DavidEwing/SNAP-Badge/docs/SNAPbadge_views-RevB_f1cd7e.pdf

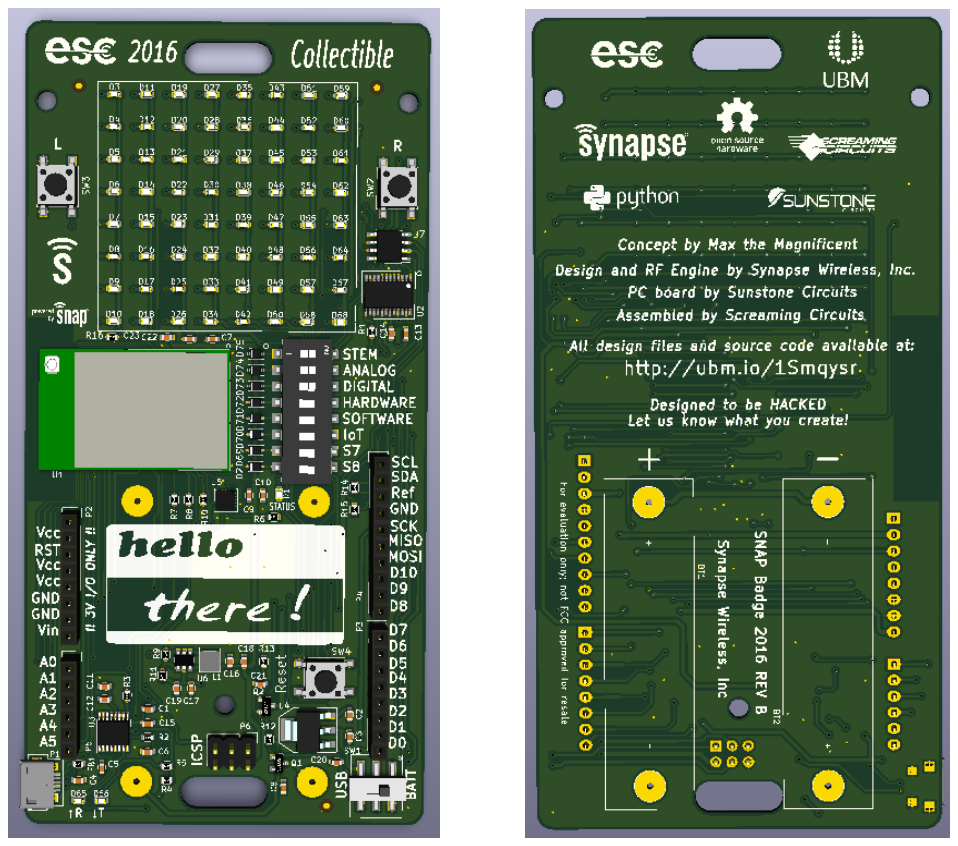
[picture p1: page 1]

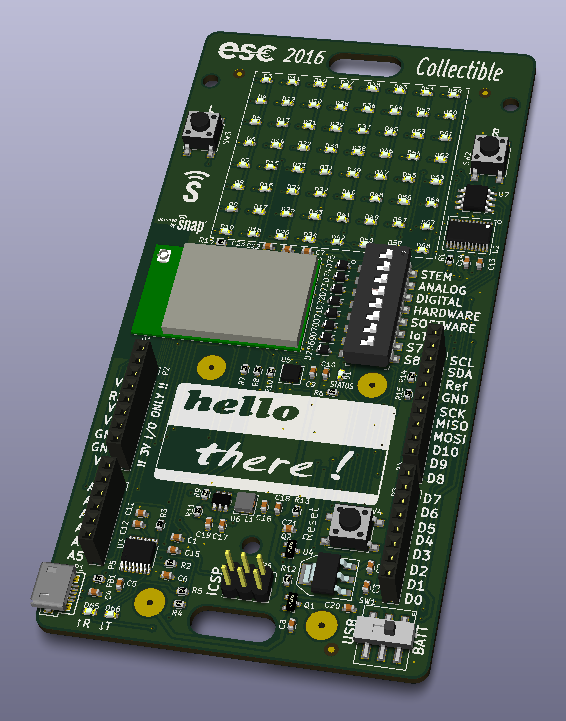
[picture p2: figure]
