DavidEwing/SNAP-Badge/docs/SNAPbadge_views-RevA_e351ad.pdf

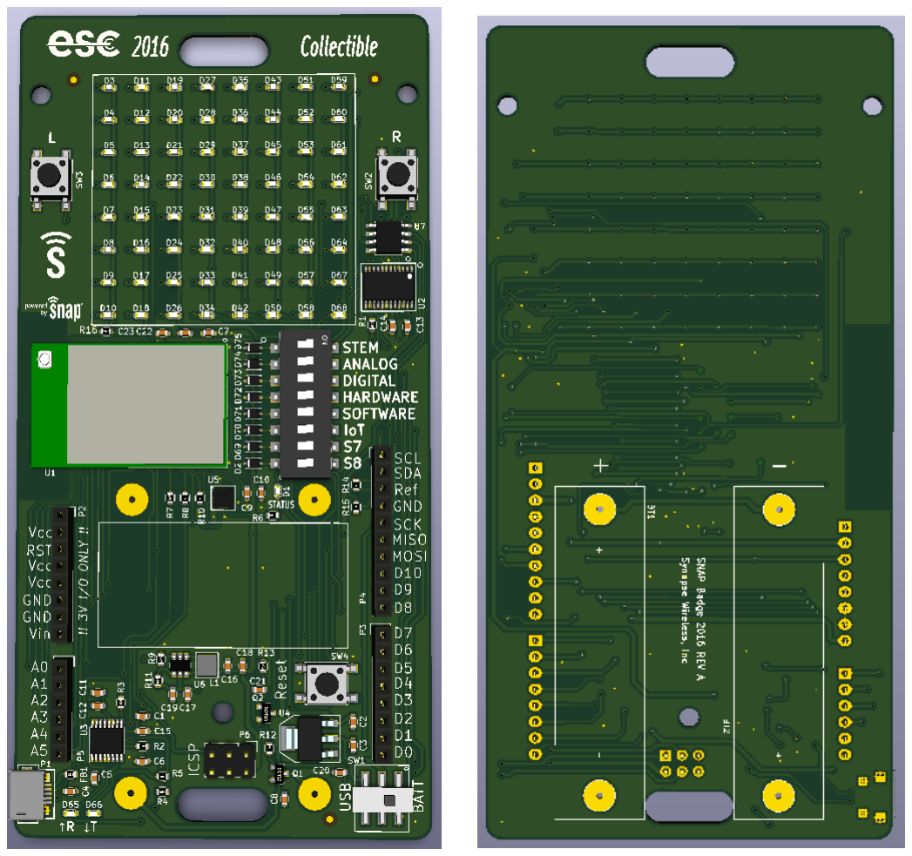
[picture p3: page 1]

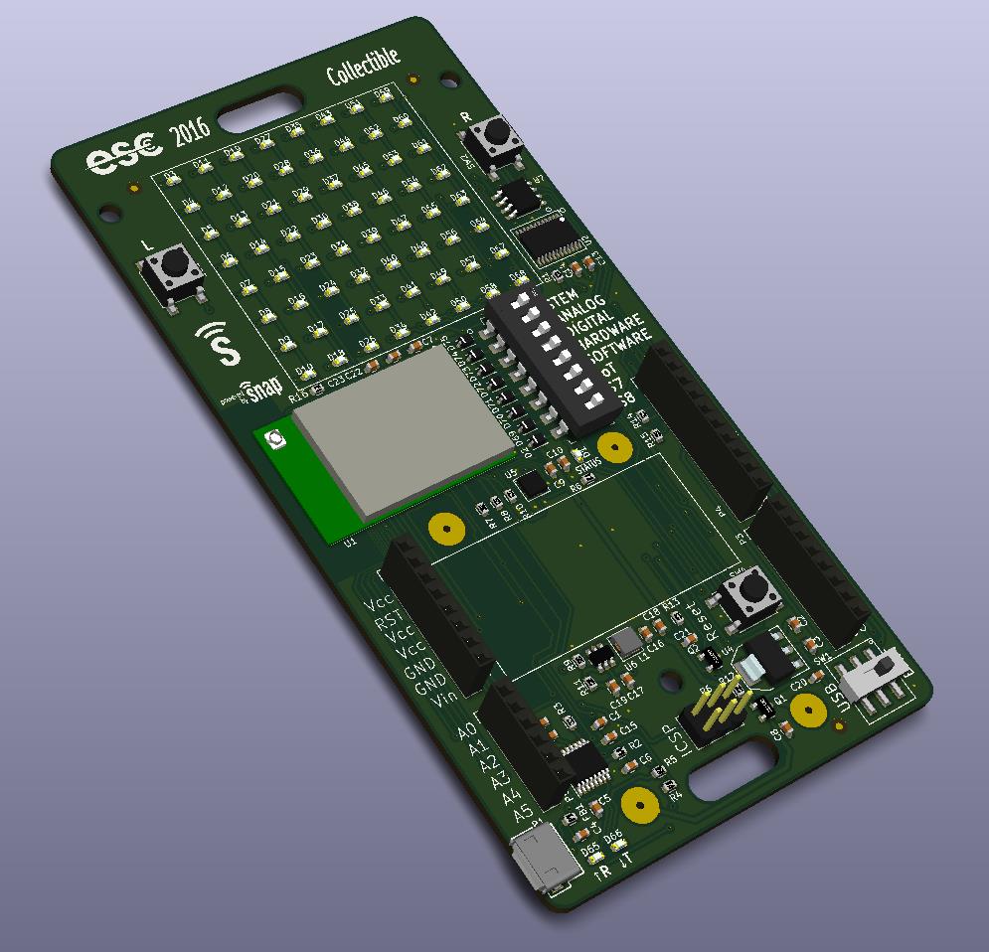
[picture p4: figure]
