DavidEwing/SNAP-Badge/docs/SNAPbadge_sch-RevB_f1cd7e.pdf

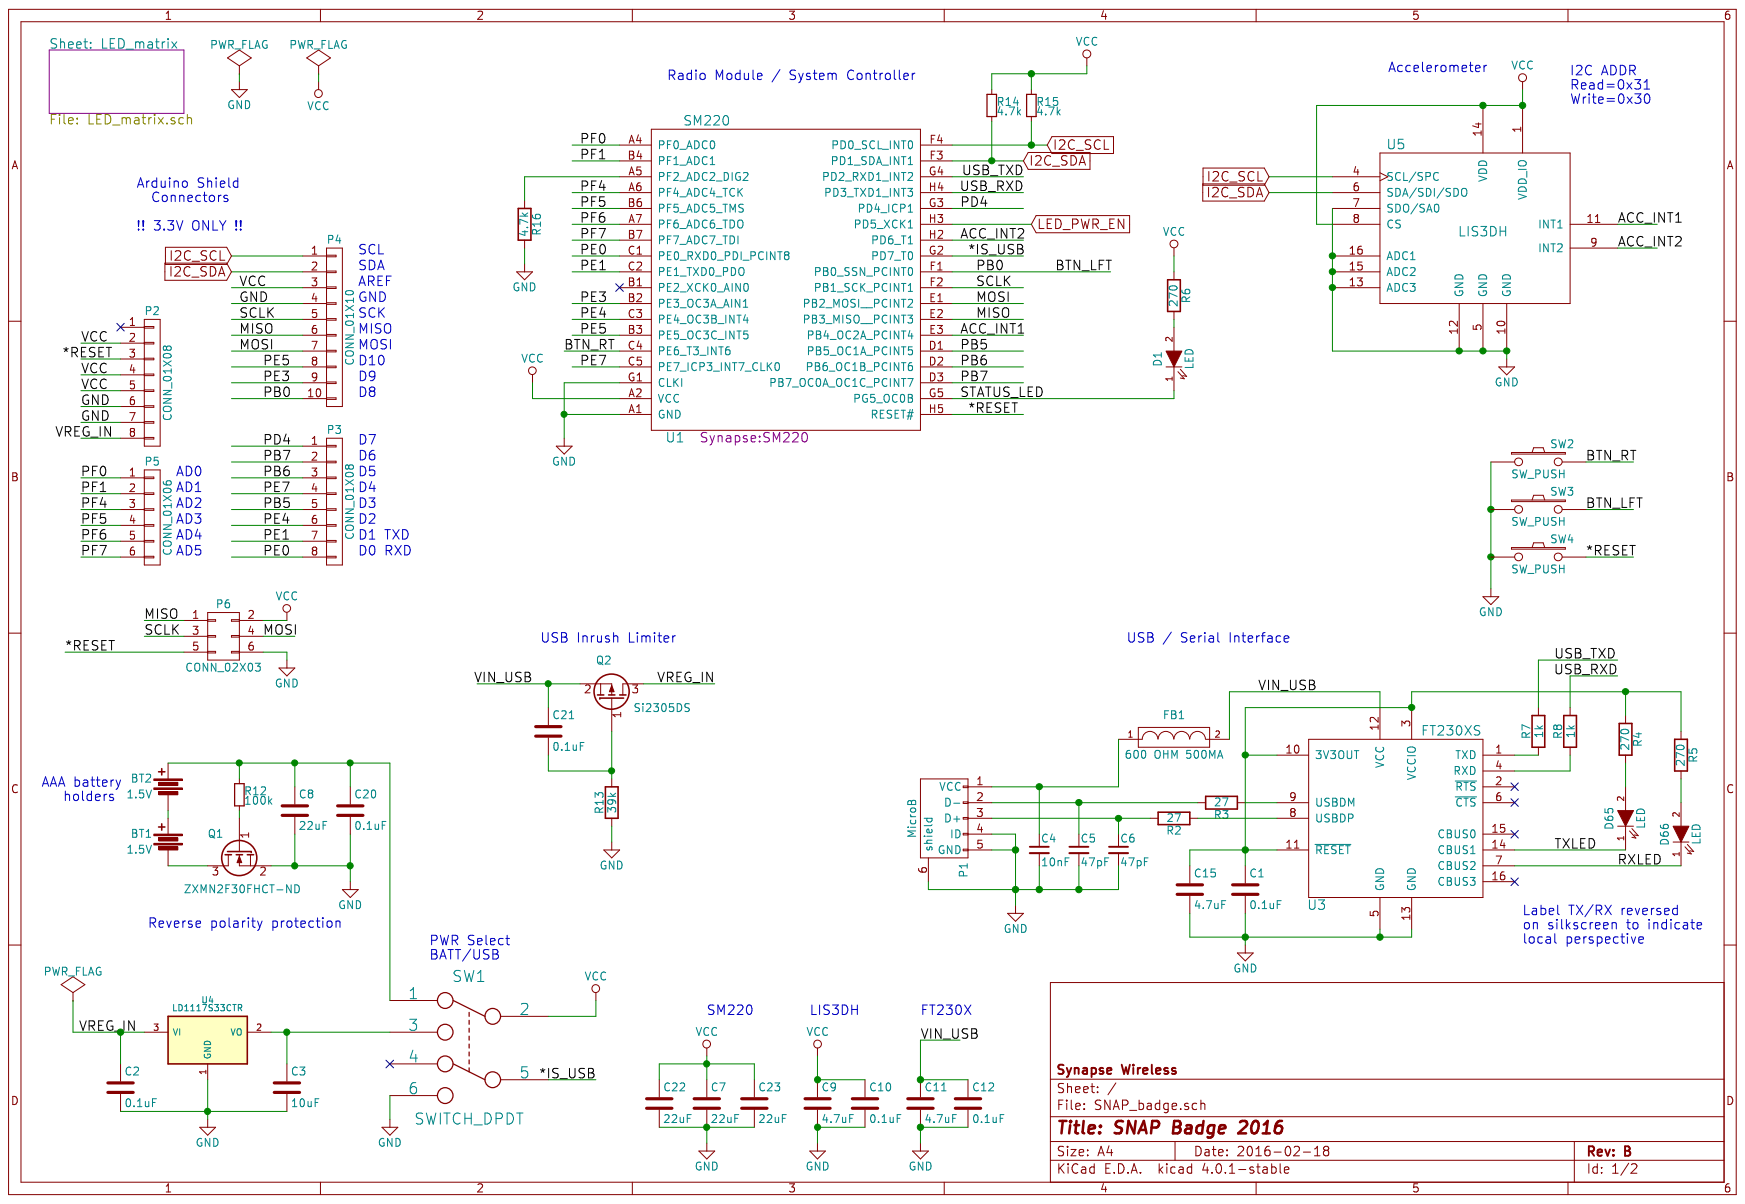
[picture p5: page 1]

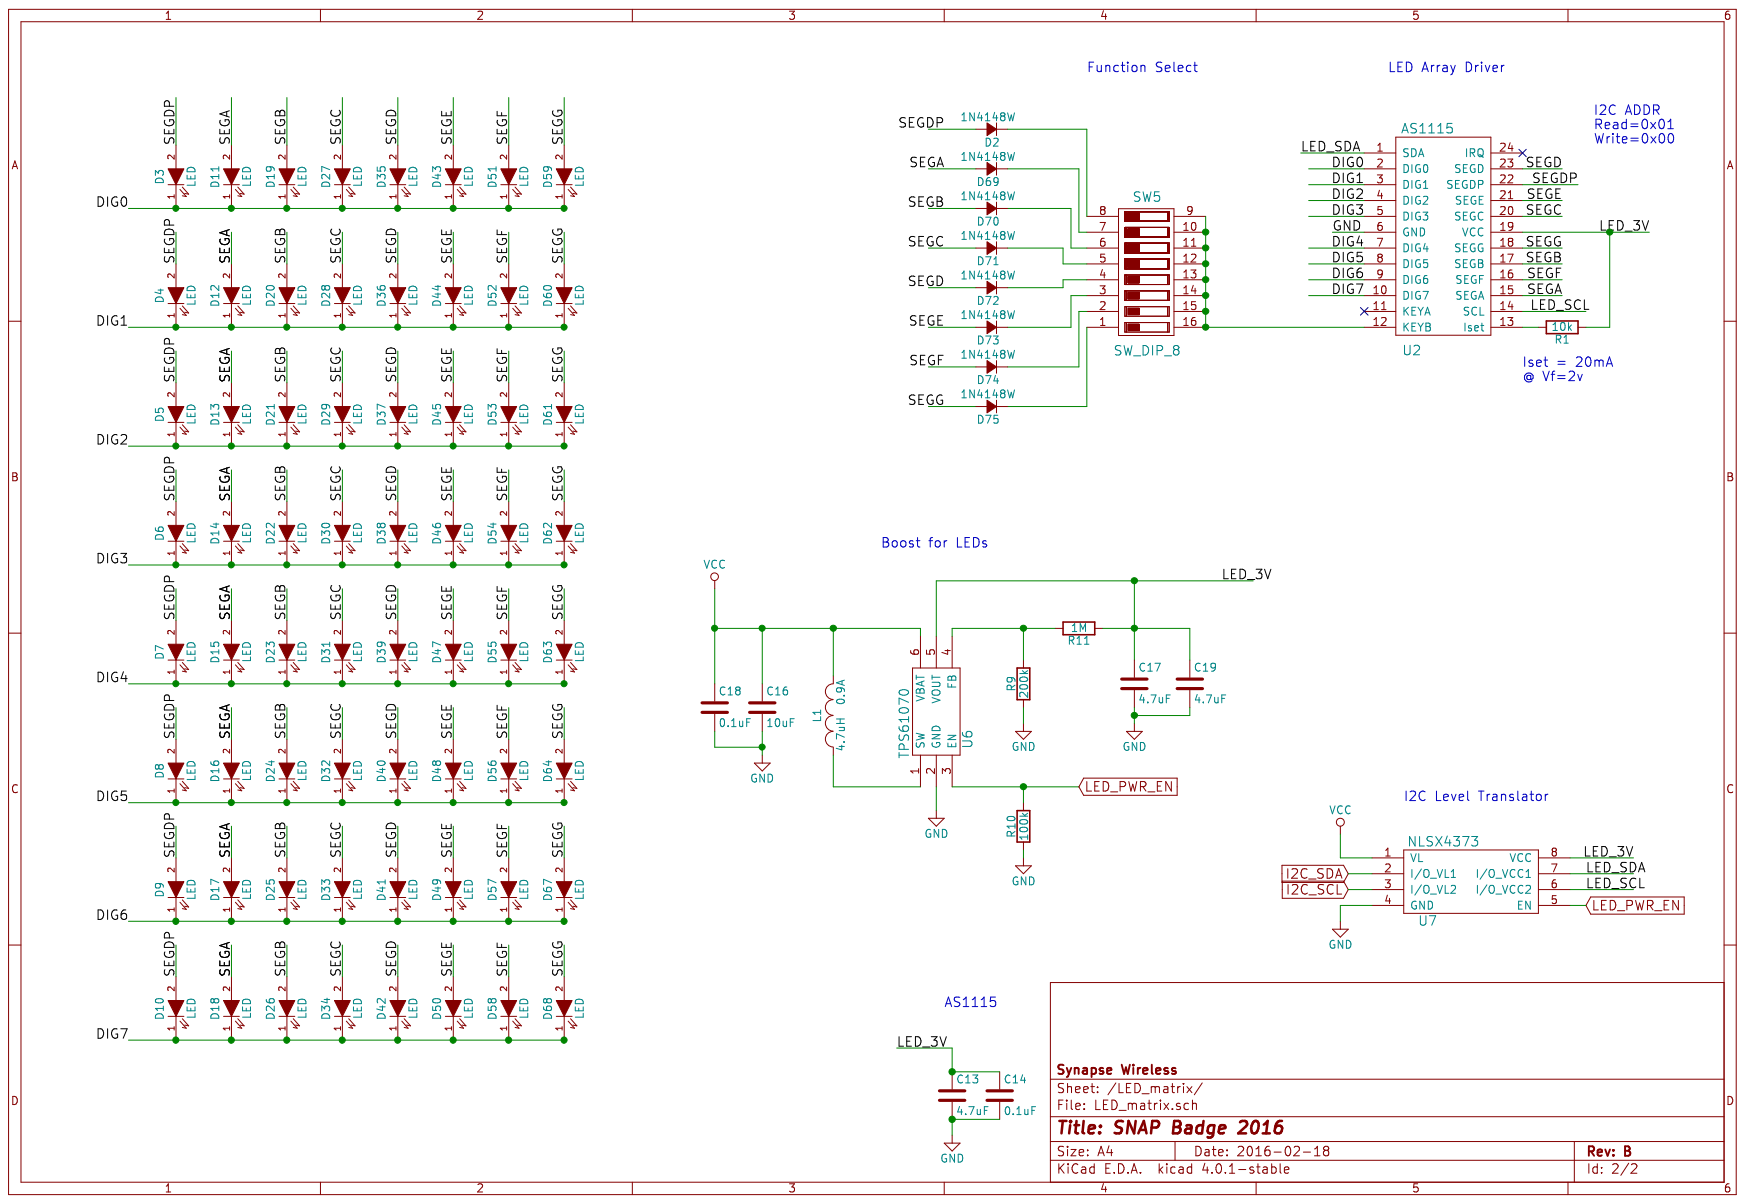
[picture p6: page 2]
