DavidEwing/SNAP-Badge/docs/SNAPbadge_sch-RevA_e351ad.pdf

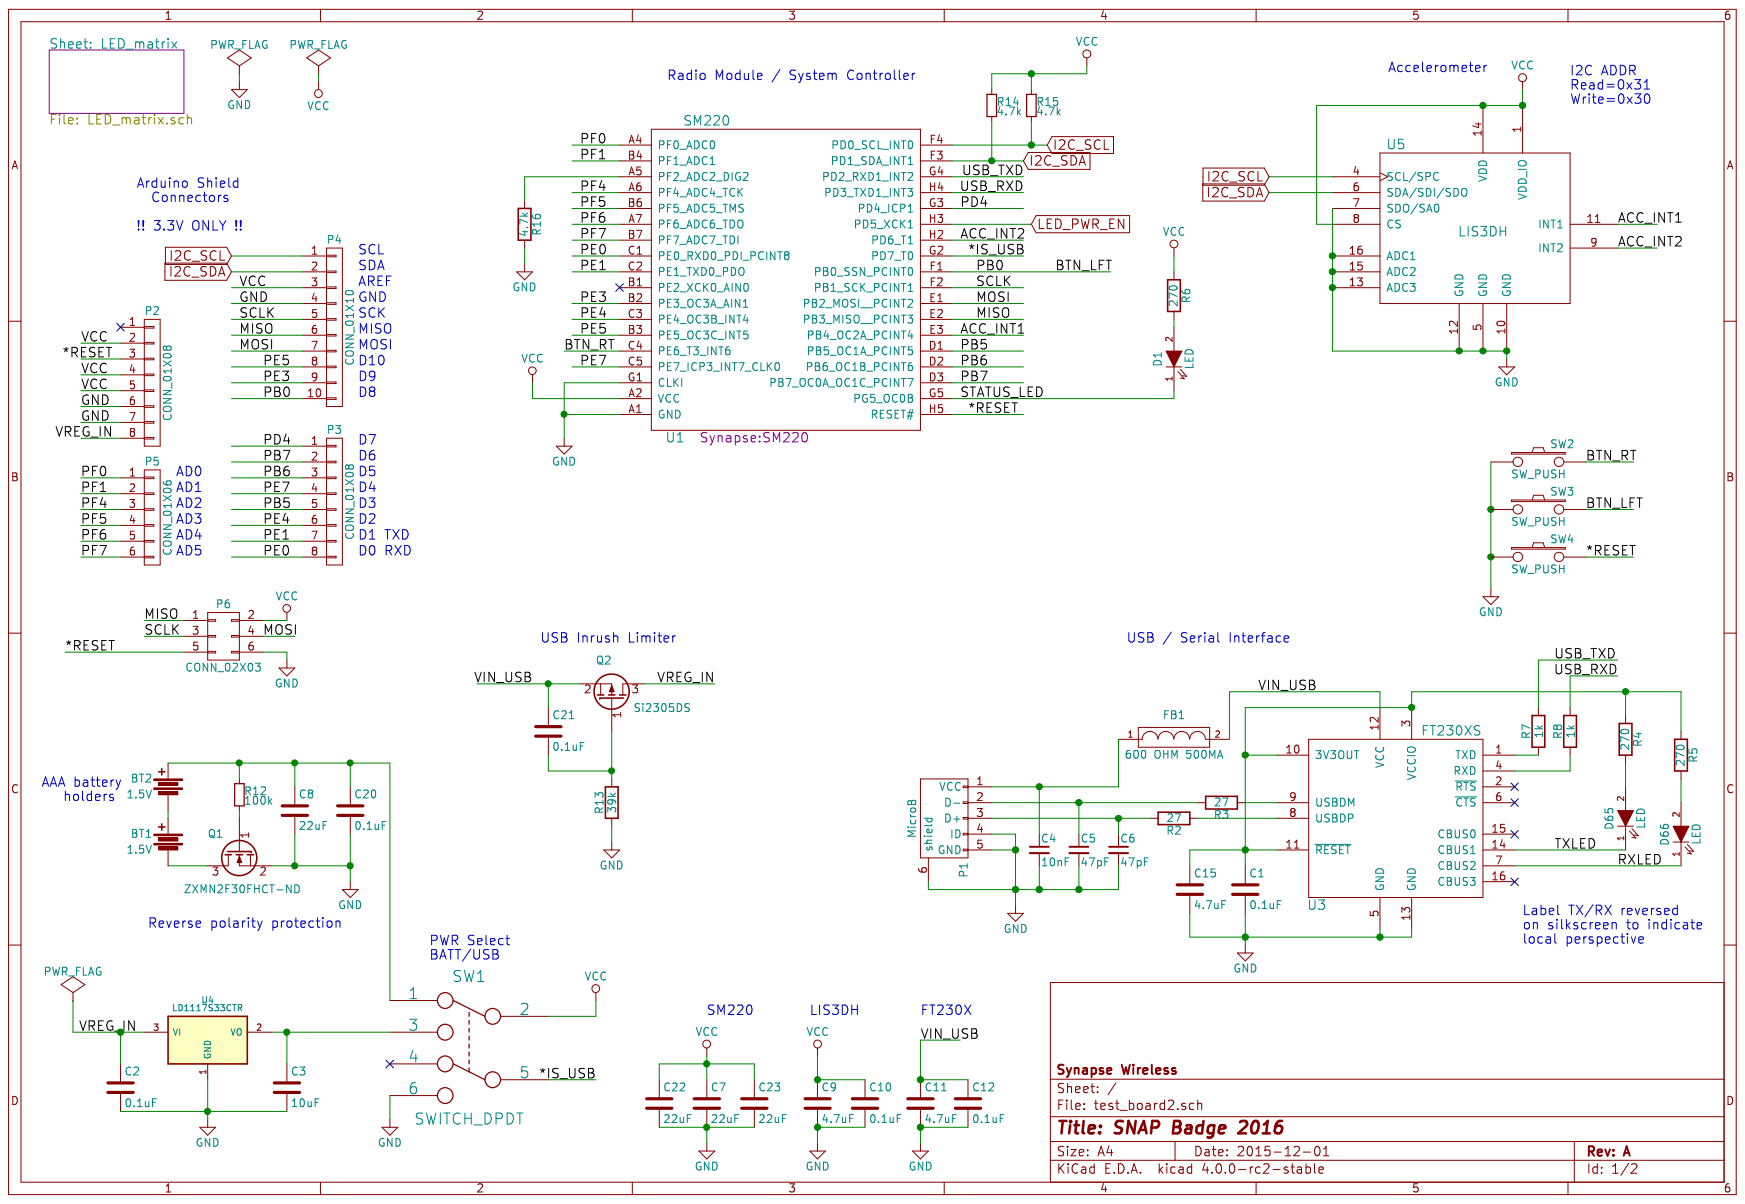
[picture p7: page 1]

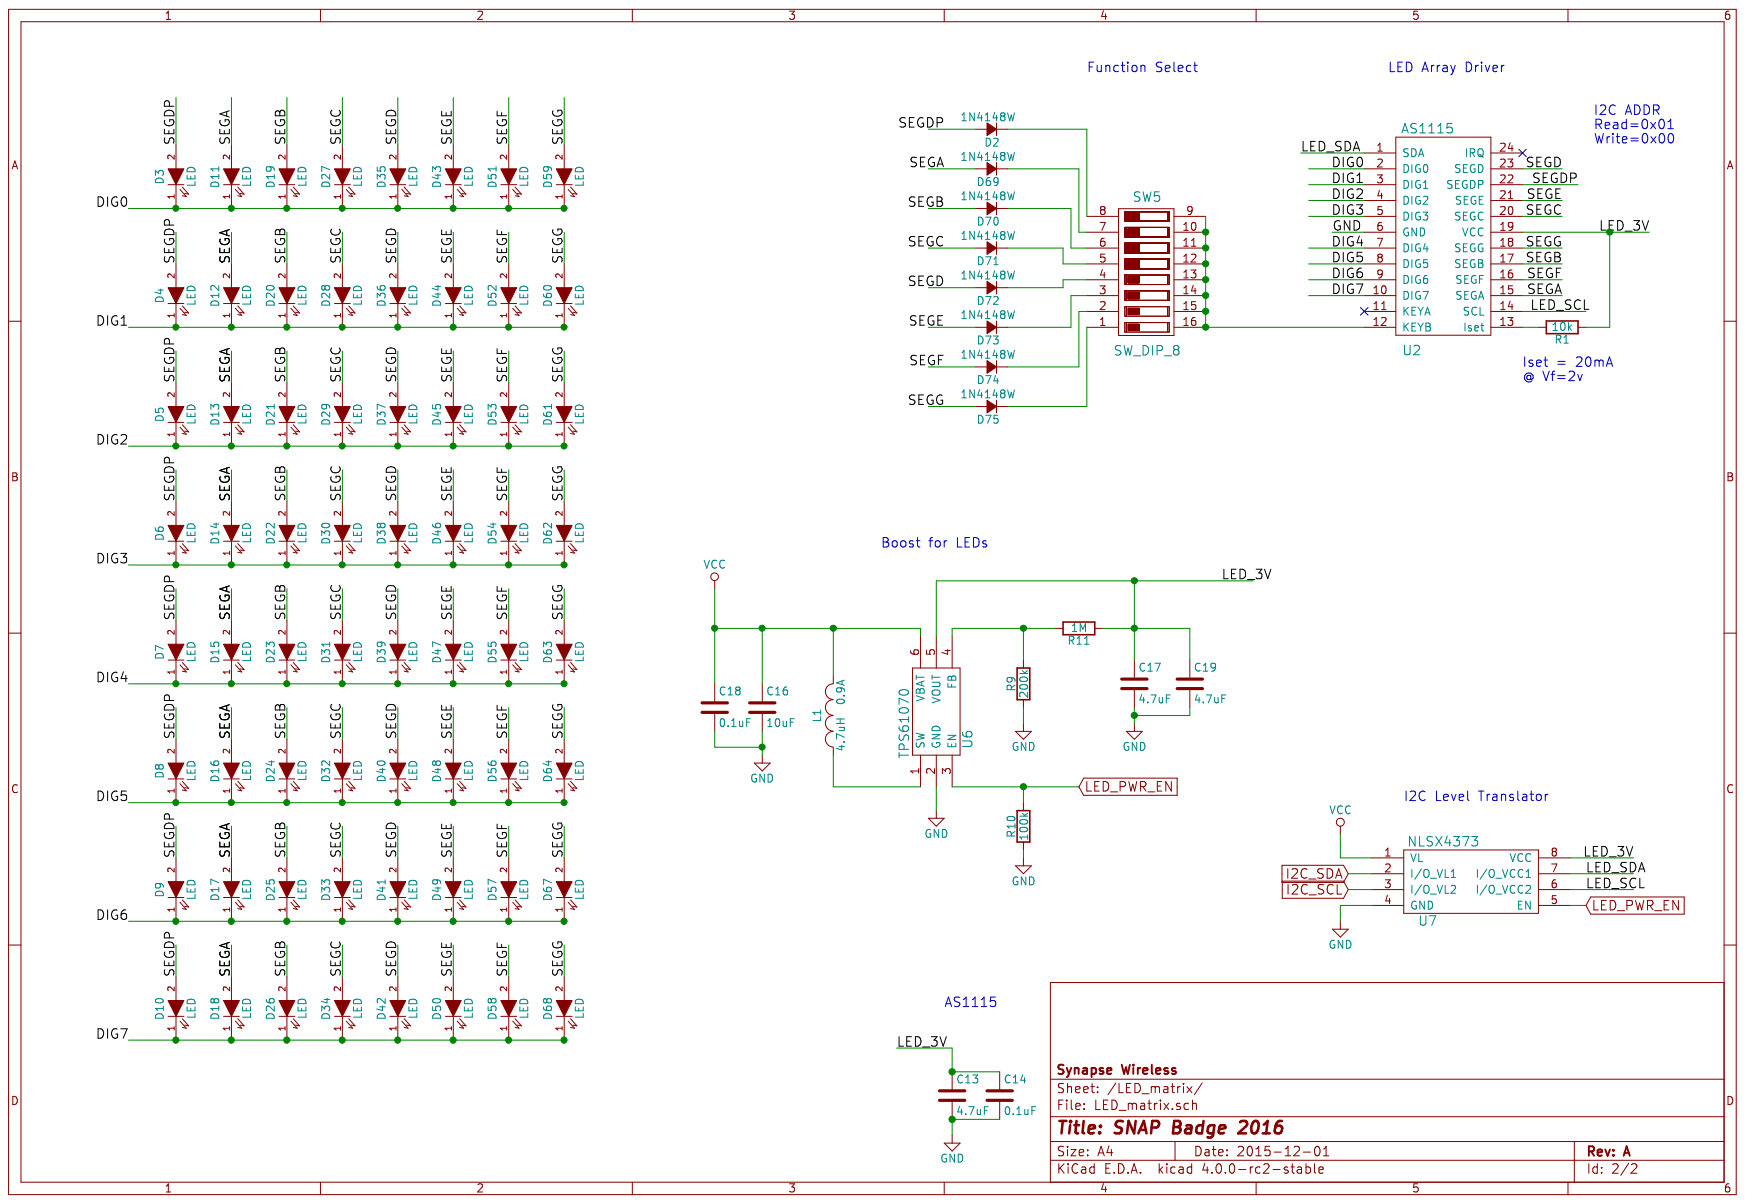
[picture p8: page 2]
