DavidEwing/SNAP-Badge/SNAP_badge.kicad_pcb

## KiCad design SNAP_badge.kicad_pcb (2016-02-18)

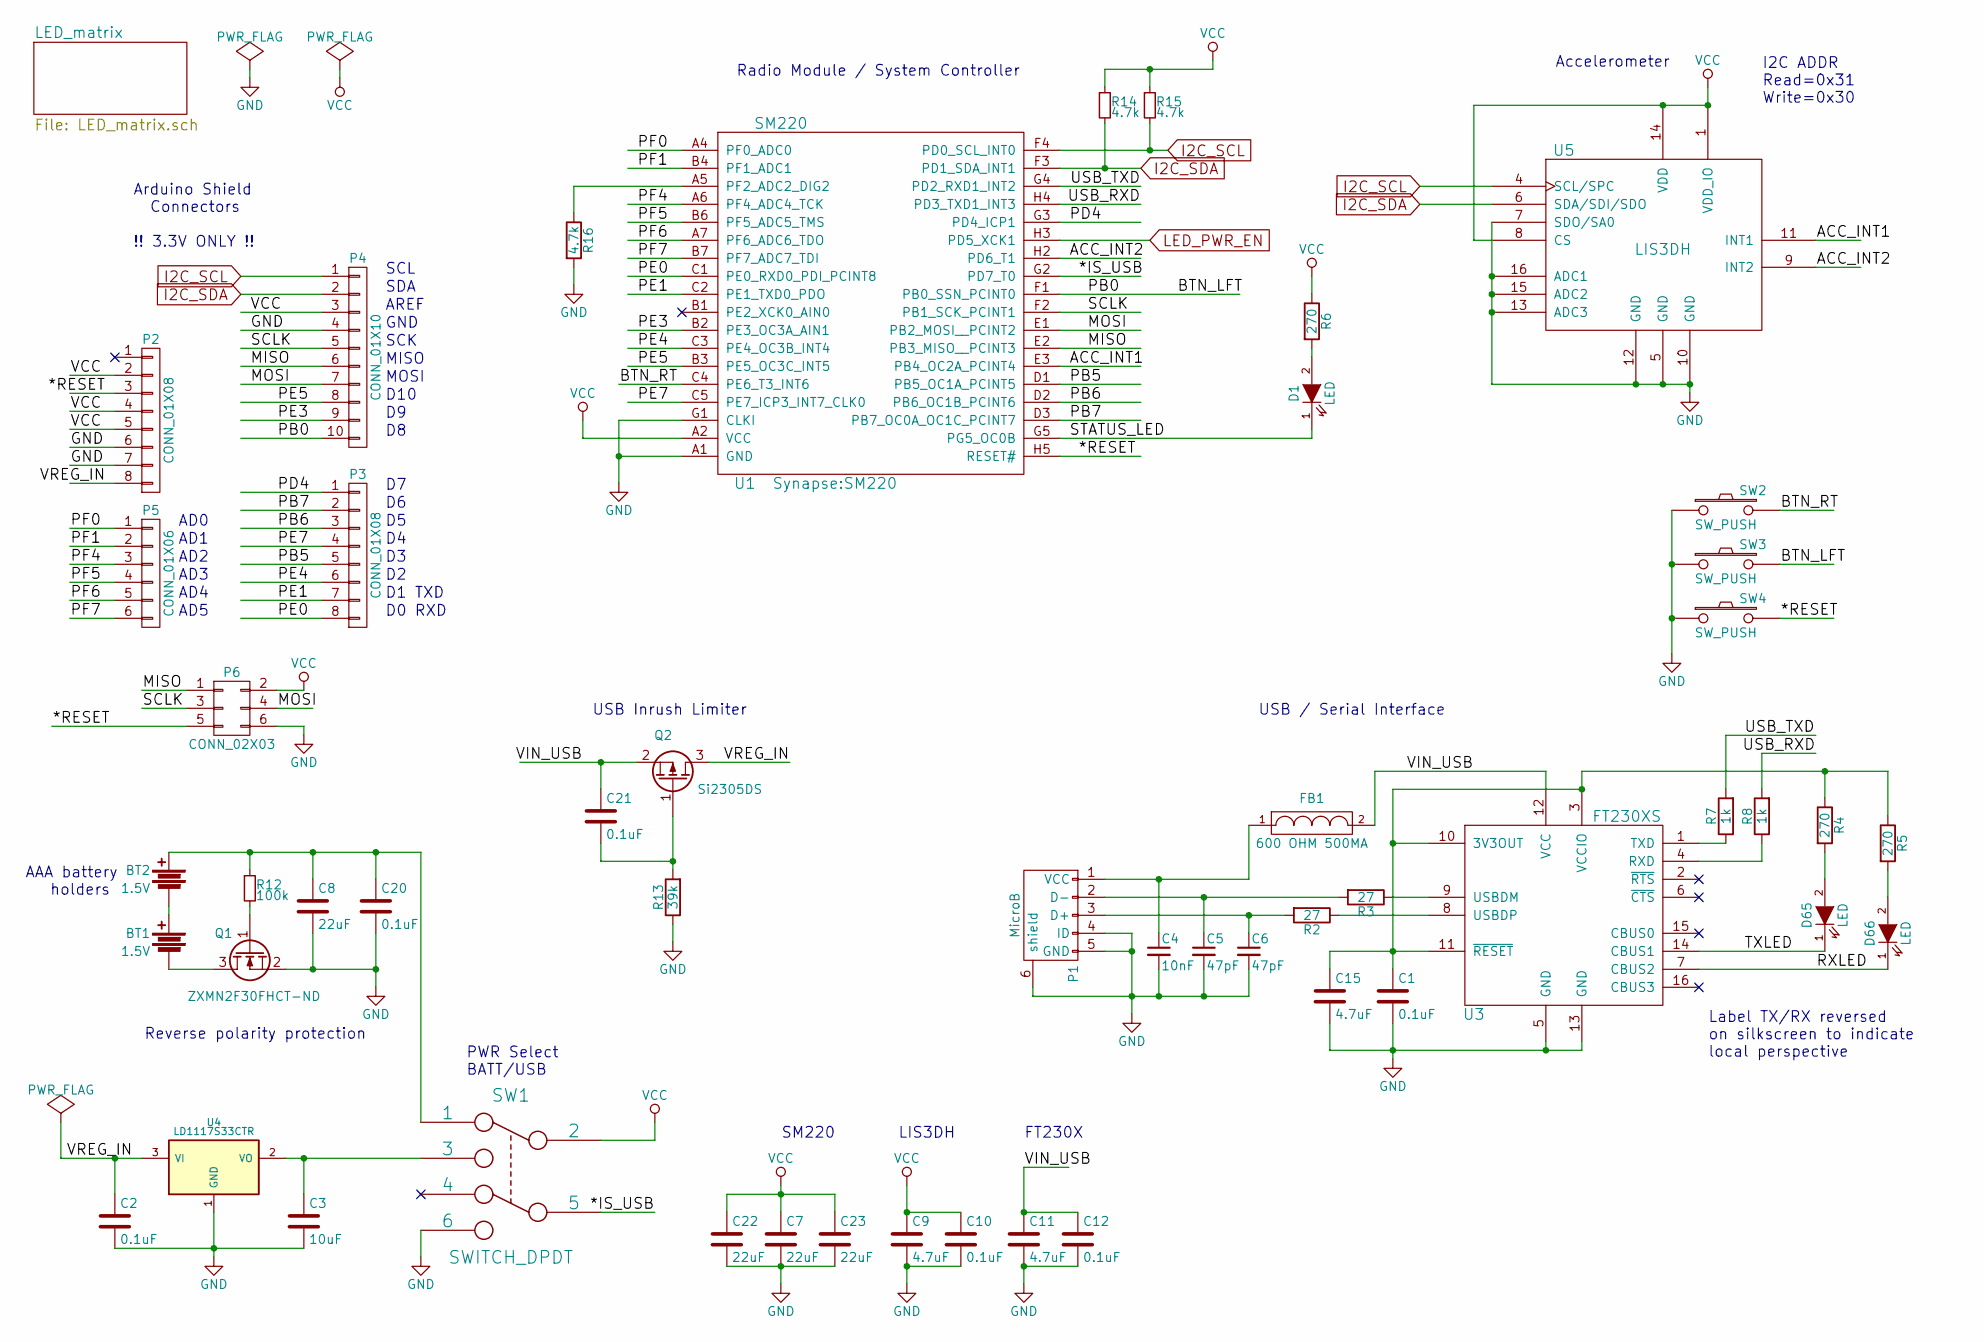
[picture p9: schematic SNAP_badge.sch, SNAP Badge 2016]

Parts:
BT1, BT2: 1.5V; BATT_2466
C1, C2, C10, C12, C20, C21: 0.1uF; C_0603
C3: 10uF; C_0603
C4: 10nF; C_0603
C5, C6: 47pF; C_0603
C7, C8, C22, C23: 22uF; C_0603
C9, C11, C15: 4.7uF; C_0603
D1, D65, D66: LED; Led_0603
FB1: 600 OHM 500MA; R_0603
P1: MicroB; USBmicroB
P2, P3: CONN_01X08; Socket_Strip_Straight_1x08
P4: CONN_01X10; Socket_Strip_Straight_1x10
P5: CONN_01X06; Socket_Strip_Straight_1x06
P6: CONN_02X03; Pin_Header_Straight_2x03
Q1: ZXMN2F30FHCT-ND; SOT-23
Q2: Si2305DS; SOT-23
R2, R3: 27; R_0603
R4, R5, R6: 270; R_0603
R7, R8: 1k; R_0603
R12: 100k; R_0603
R13: 39k; R_0603
R14, R15, R16: 4.7k; R_0603
SW1: SWITCH_DPDT; SO-DPDT-6
SW2, SW3, SW4: SW_PUSH; SW_SPST_PTS645
U1: SM220
U3: FT230XS; SSOP-16_3.9x4.9mm_Pitch0.635mm
U4: LD1117S33CTR; SOT-223
U5: LIS3DH; LGA16_3x3

Connections:
/*IS_USB: SW1.5, U1.G2 (PD7_T0)
/*RESET: P2.3, P6.5, SW4.2, U1.H5 (RESET#)
/ACC_INT1: U1.E3 (PB4_OC2A_PCINT4), U5.11 (INT1)
/ACC_INT2: U1.H2 (PD6_T1), U5.9 (INT2)
/BTN_LFT: P4.10, SW3.2, U1.F1 (PB0_SSN_PCINT0)
/BTN_RT: SW2.2, U1.C4 (PE6_T3_INT6)
/MISO: P4.6, P6.1, U1.E2 (PB3_MISO__PCINT3)
/MOSI: P4.7, P6.4, U1.E1 (PB2_MOSI__PCINT2)
/PB5: P3.5, U1.D1 (PB5_OC1A_PCINT5)
/PB6: P3.3, U1.D2 (PB6_OC1B_PCINT6)
/PB7: P3.2, U1.D3 (PB7_OC0A_OC1C_PCINT7)
/PD4: P3.1, U1.G3 (PD4_ICP1)
/PE0: P3.8, U1.C1 (PE0_RXD0_PDI_PCINT8)
/PE1: P3.7, U1.C2 (PE1_TXD0_PDO)
/PE3: P4.9, U1.B2 (PE3_OC3A_AIN1)
/PE4: P3.6, U1.C3 (PE4_OC3B_INT4)
/PE5: P4.8, U1.B3 (PE5_OC3C_INT5)
/PE7: P3.4, U1.C5 (PE7_ICP3_INT7_CLK0)
/PF0: P5.1, U1.A4 (PF0_ADC0)
/PF1: P5.2, U1.B4 (PF1_ADC1)
/PF4: P5.3, U1.A6 (PF4_ADC4_TCK)
/PF5: P5.4, U1.B6 (PF5_ADC5_TMS)
/PF6: P5.5, U1.A7 (PF6_ADC6_TDO)
/PF7: P5.6, U1.B7 (PF7_ADC7_TDI)
/RXLED: D66.1 (K), U3.7 (CBUS2)
/SCLK: P4.5, P6.3, U1.F2 (PB1_SCK_PCINT1)
/STATUS_LED: D1.1 (K), U1.G5 (PG5_OC0B)
/TXLED: D65.1 (K), U3.14 (CBUS1)
/USB_RXD: R8.2, U1.H4 (PD3_TXD1_INT3)
/USB_TXD: R7.2, U1.G4 (PD2_RXD1_INT2)
/VIN_USB: C11.1, C12.1, C21.1, FB1.2, Q2.2 (S), U3.12 (VCC)
/VREG_IN: C2.1, P2.8, Q2.3 (D), U4.3 (VI)
GND: C1.2, C2.2, C3.2, C4.2, C5.2, C6.2, C7.2, C8.2, C9.2, C10.2, C11.2, C12.2, C15.2, C20.2, C22.2, C23.2, P1.4 (ID), P1.5 (GND), P1.6 (shield), P2.6, P2.7, P4.4, P6.6, Q1.2 (S), R13.1, R16.2, SW1.6, SW2.1, SW3.1, SW4.1, U1.A1 (GND), U1.A8 (GND), U1.B8 (GND), U1.D8 (GND), U1.F8 (GND), U1.G1 (CLKI), U1.G8 (GND), U1.H1 (GND), U1.H8 (GND), U3.5 (GND), U3.13 (GND), U4.1 (GND), U5.5 (GND), U5.7 (SDO/SA0), U5.10 (GND), U5.12 (GND), U5.13 (ADC3), U5.15 (ADC2), U5.16 (ADC1); also elsewhere on the board
I2C_SCL: P4.1, R15.2, U1.F4 (PD0_SCL_INT0), U5.4 (SCL/SPC); also elsewhere on the board
I2C_SDA: P4.2, R14.2, U1.F3 (PD1_SDA_INT1), U5.6 (SDA/SDI/SDO); also elsewhere on the board
LED_PWR_EN: U1.H3 (PD5_XCK1); also elsewhere on the board
unnamed: BT1.1, BT2.2
unnamed: BT1.2, Q1.3 (D)
unnamed: BT2.1, C8.1, C20.1, R12.1, SW1.1
unnamed: C1.1, C15.1, R4.1, R5.1, U3.3 (VCCIO), U3.10 (3V3OUT), U3.11 (~RESET)
unnamed: C3.1, SW1.3, U4.2 (VO)
unnamed: C4.1, FB1.1, P1.1 (VCC)
unnamed: C5.1, P1.2 (D-), R3.2
unnamed: C6.1, P1.3 (D+), R2.2
unnamed: C21.2, Q2.1 (G), R13.2
unnamed: D1.2 (A), R6.2
unnamed: D65.2 (A), R4.2
unnamed: D66.2 (A), R5.2
unnamed: Q1.1 (G), R12.2
unnamed: R2.1, U3.8 (USBDP)
unnamed: R3.1, U3.9 (USBDM)
unnamed: R7.1, U3.1 (TXD)
unnamed: R8.1, U3.4 (RXD)
unnamed: R16.1, U1.A5 (PF2_ADC2_DIG2)
VCC: C7.1, C9.1, C10.1, C22.1, C23.1, P2.2, P2.4, P2.5, P4.3, P6.2, R6.1, R14.1, R15.1, SW1.2, U1.A2 (VCC), U1.A3 (VCC), U5.1 (VDD_IO), U5.8 (CS), U5.14 (VDD); also elsewhere on the board

Notes on the sheet:
Reverse polarity protection
PWR Select BATT/USB
I2C ADDR Read=0x31 Write=0x30
Accelerometer
USB / Serial Interface
Radio Module / System Controller
SM220
LIS3DH
FT230X
AD0
AD1
AD2
AD3
AD4
AD5
SCL
SDA
AREF
GND
SCK
MISO
MOSI
D10
D1 TXD
D0 RXD
Arduino Shield Connectors !! 3.3V ONLY !!
AAA battery holders
USB Inrush Limiter
Label TX/RX reversed on silkscreen to indicate local perspective

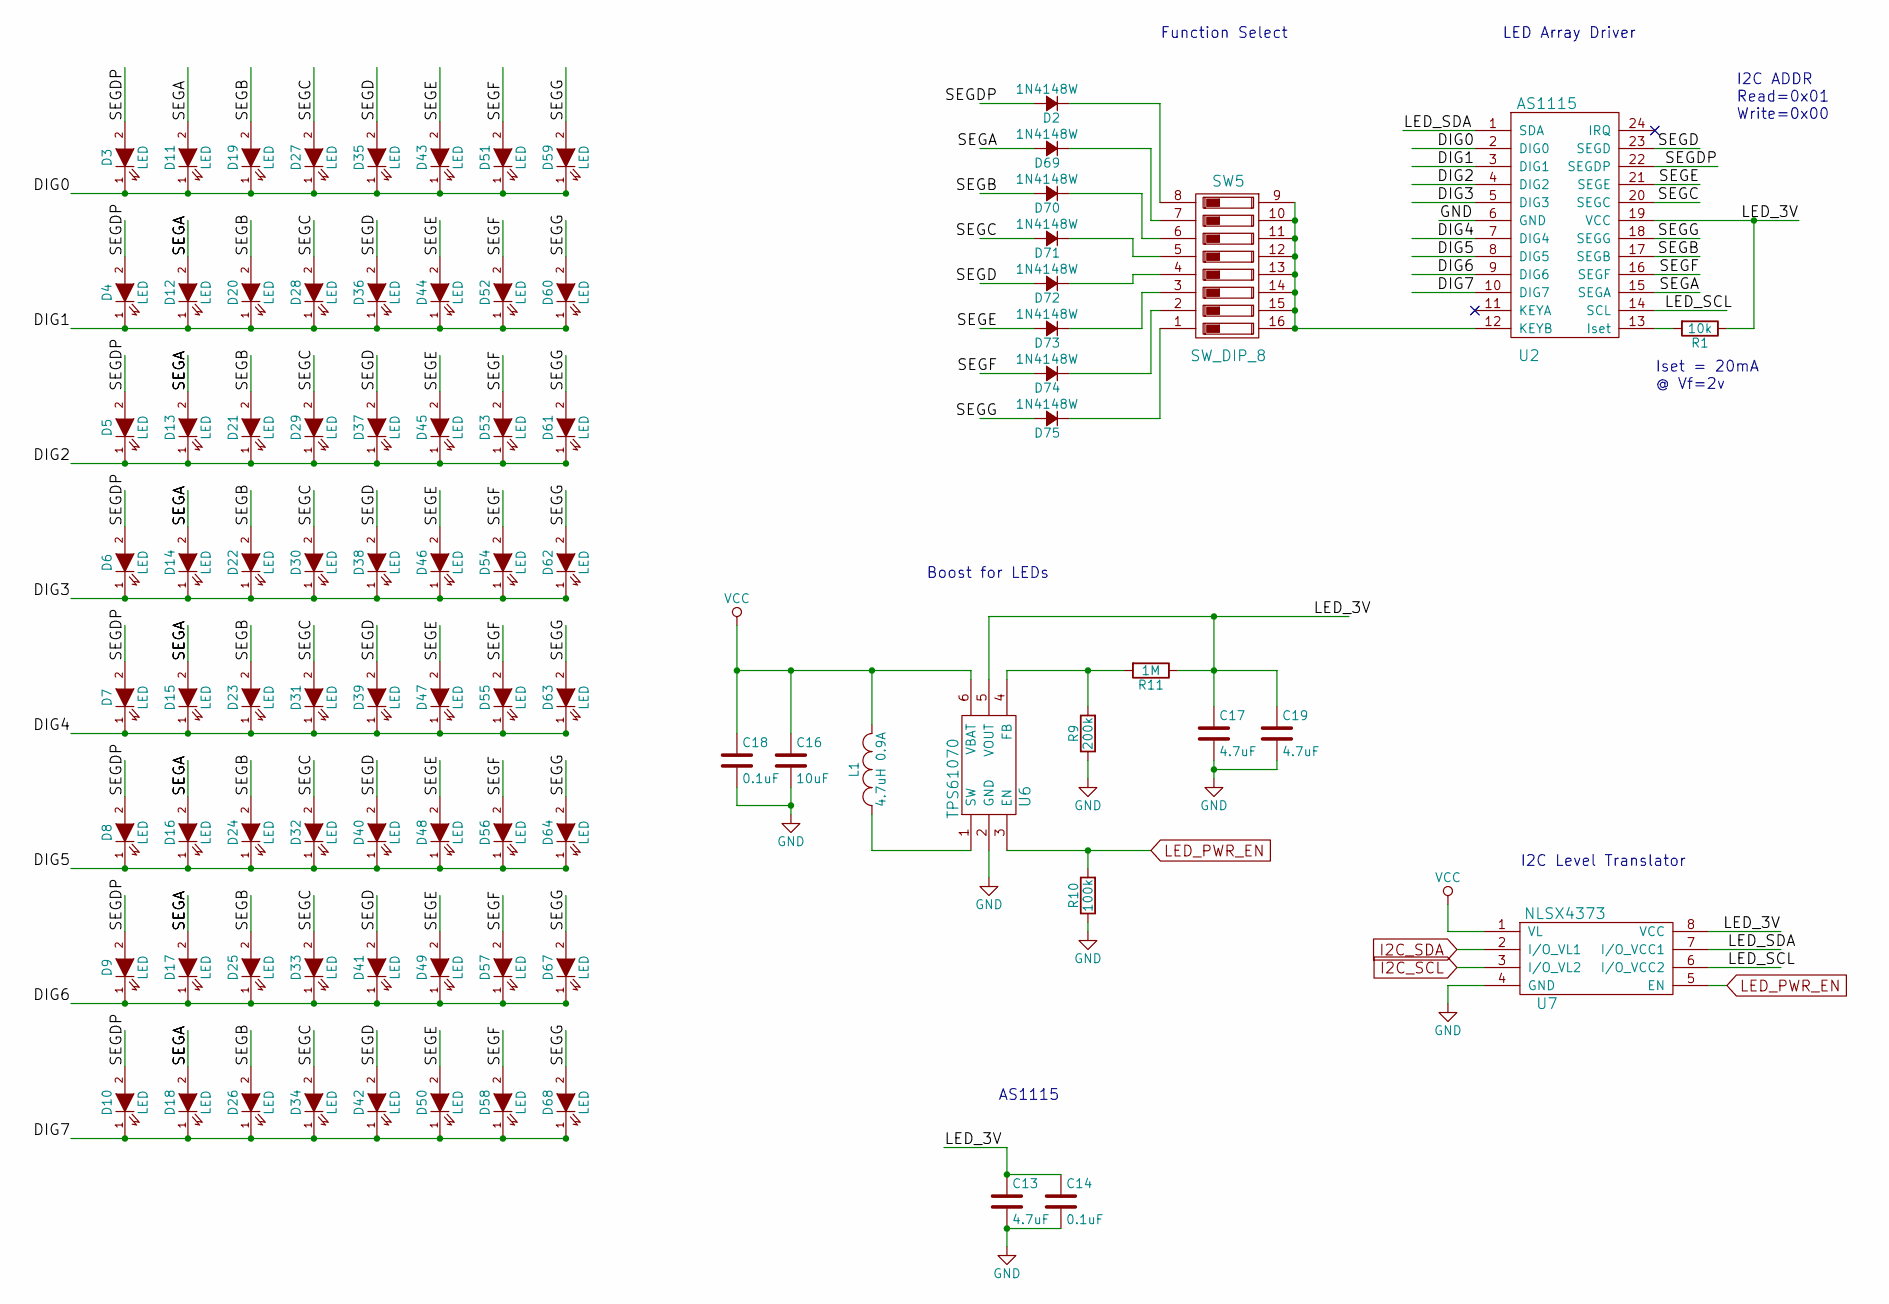
[picture p10: schematic LED_matrix.sch, SNAP Badge 2016]

Parts:
C13, C17, C19: 4.7uF; C_0603
C14, C18: 0.1uF; C_0603
C16: 10uF; C_0603
D2, D69, D70, D71, D72, D73, D74, D75: 1N4148W; SOD-323
D3, D4, D5, D6, D7, D8, D9, D10, D11, D12, D13, D14, D15, D16, D17, D18, D19, D20, D21, D22, D23, D24, D25, D26, D27, D28, D29, D30, D31, D32, D33, D34, D35, D36, D37, D38, D39, D40, D41, D42, D43, D44, D45, D46, D47, D48, D49, D50, D51, D52, D53, D54, D55, D56, D57, D58, D59, D60, D61, D62, D63, D64, D67, D68: LED; Led_0603
L1: 4.7uH 0.9A; TYS-2
R1: 10k; R_0603
R9: 200k; R_0603
R10: 100k; R_0603
R11: 1M; R_0603
SW5: SW_DIP_8; DIPSW-16
U2: AS1115; QSOP-24
U6: TPS61070; TSOT-6-MK06A
U7: NLSX4373; SOIC-8_3.9x4.9mm_Pitch1.27mm

Connections:
/LED_matrix/DIG0: D3.1 (K), D11.1 (K), D19.1 (K), D27.1 (K), D35.1 (K), D43.1 (K), D51.1 (K), D59.1 (K), U2.2 (DIG0)
/LED_matrix/DIG1: D4.1 (K), D12.1 (K), D20.1 (K), D28.1 (K), D36.1 (K), D44.1 (K), D52.1 (K), D60.1 (K), U2.3 (DIG1)
/LED_matrix/DIG2: D5.1 (K), D13.1 (K), D21.1 (K), D29.1 (K), D37.1 (K), D45.1 (K), D53.1 (K), D61.1 (K), U2.4 (DIG2)
/LED_matrix/DIG3: D6.1 (K), D14.1 (K), D22.1 (K), D30.1 (K), D38.1 (K), D46.1 (K), D54.1 (K), D62.1 (K), U2.5 (DIG3)
/LED_matrix/DIG4: D7.1 (K), D15.1 (K), D23.1 (K), D31.1 (K), D39.1 (K), D47.1 (K), D55.1 (K), D63.1 (K), U2.7 (DIG4)
/LED_matrix/DIG5: D8.1 (K), D16.1 (K), D24.1 (K), D32.1 (K), D40.1 (K), D48.1 (K), D56.1 (K), D64.1 (K), U2.8 (DIG5)
/LED_matrix/DIG6: D9.1 (K), D17.1 (K), D25.1 (K), D33.1 (K), D41.1 (K), D49.1 (K), D57.1 (K), D67.1 (K), U2.9 (DIG6)
/LED_matrix/DIG7: D10.1 (K), D18.1 (K), D26.1 (K), D34.1 (K), D42.1 (K), D50.1 (K), D58.1 (K), D68.1 (K), U2.10 (DIG7)
/LED_matrix/LED_3V: C13.1, C14.1, C17.1, C19.1, R1.1, R11.1, U2.19 (VCC), U6.5 (VOUT), U7.8 (VCC)
/LED_matrix/LED_SCL: U2.14 (SCL), U7.6 (I/O_VCC2)
/LED_matrix/LED_SDA: U2.1 (SDA), U7.7 (I/O_VCC1)
/LED_matrix/SEGA: D11.2 (A), D12.2 (A), D13.2 (A), D14.2 (A), D15.2 (A), D16.2 (A), D17.2 (A), D18.2 (A), D69.2 (A), U2.15 (SEGA)
/LED_matrix/SEGB: D19.2 (A), D20.2 (A), D21.2 (A), D22.2 (A), D23.2 (A), D24.2 (A), D25.2 (A), D26.2 (A), D70.2 (A), U2.17 (SEGB)
/LED_matrix/SEGC: D27.2 (A), D28.2 (A), D29.2 (A), D30.2 (A), D31.2 (A), D32.2 (A), D33.2 (A), D34.2 (A), D71.2 (A), U2.20 (SEGC)
/LED_matrix/SEGD: D35.2 (A), D36.2 (A), D37.2 (A), D38.2 (A), D39.2 (A), D40.2 (A), D41.2 (A), D42.2 (A), D72.2 (A), U2.23 (SEGD)
/LED_matrix/SEGDP: D2.2 (A), D3.2 (A), D4.2 (A), D5.2 (A), D6.2 (A), D7.2 (A), D8.2 (A), D9.2 (A), D10.2 (A), U2.22 (SEGDP)
/LED_matrix/SEGE: D43.2 (A), D44.2 (A), D45.2 (A), D46.2 (A), D47.2 (A), D48.2 (A), D49.2 (A), D50.2 (A), D73.2 (A), U2.21 (SEGE)
/LED_matrix/SEGF: D51.2 (A), D52.2 (A), D53.2 (A), D54.2 (A), D55.2 (A), D56.2 (A), D57.2 (A), D58.2 (A), D74.2 (A), U2.16 (SEGF)
/LED_matrix/SEGG: D59.2 (A), D60.2 (A), D61.2 (A), D62.2 (A), D63.2 (A), D64.2 (A), D67.2 (A), D68.2 (A), D75.2 (A), U2.18 (SEGG)
GND: C13.2, C14.2, C16.2, C17.2, C18.2, C19.2, R9.1, R10.1, U2.6 (GND), U6.2 (GND), U7.4 (GND); also elsewhere on the board
I2C_SCL: U7.3 (I/O_VL2); also elsewhere on the board
I2C_SDA: U7.2 (I/O_VL1); also elsewhere on the board
LED_PWR_EN: R10.2, U6.3 (EN), U7.5 (EN); also elsewhere on the board
unnamed: D2.1 (K), SW5.8
unnamed: D69.1 (K), SW5.7
unnamed: D70.1 (K), SW5.6
unnamed: D71.1 (K), SW5.5
unnamed: D72.1 (K), SW5.4
unnamed: D73.1 (K), SW5.3
unnamed: D74.1 (K), SW5.2
unnamed: D75.1 (K), SW5.1
unnamed: L1.1, U6.1 (SW)
unnamed: R1.2, U2.13 (Iset)
unnamed: R9.2, R11.2, U6.4 (FB)
unnamed: SW5.9, SW5.10, SW5.11, SW5.12, SW5.13, SW5.14, SW5.15, SW5.16, U2.12 (KEYB)
VCC: C16.1, C18.1, L1.2, U6.6 (VBAT), U7.1 (VL); also elsewhere on the board

Notes on the sheet:
AS1115
Boost for LEDs
LED Array Driver
Function Select
I2C ADDR Read=0x01 Write=0x00
Iset = 20mA @ Vf=2v
I2C Level Translator

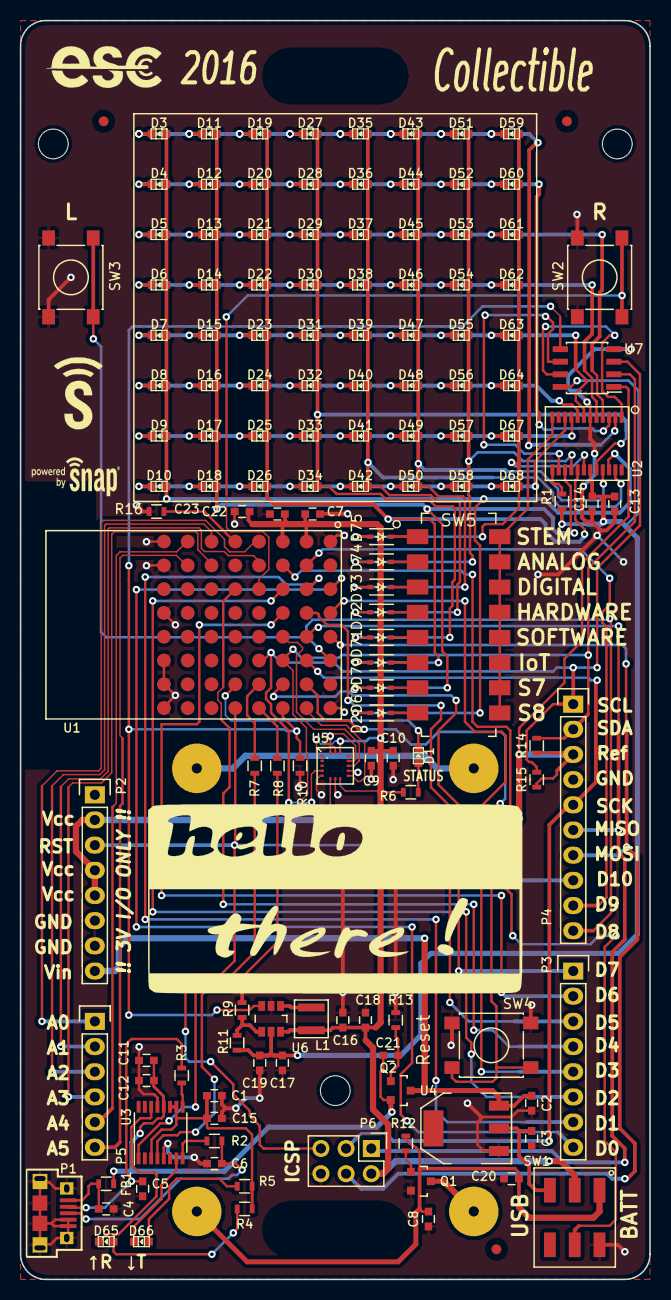
[picture p11: board SNAP_badge.kicad_pcb from above]

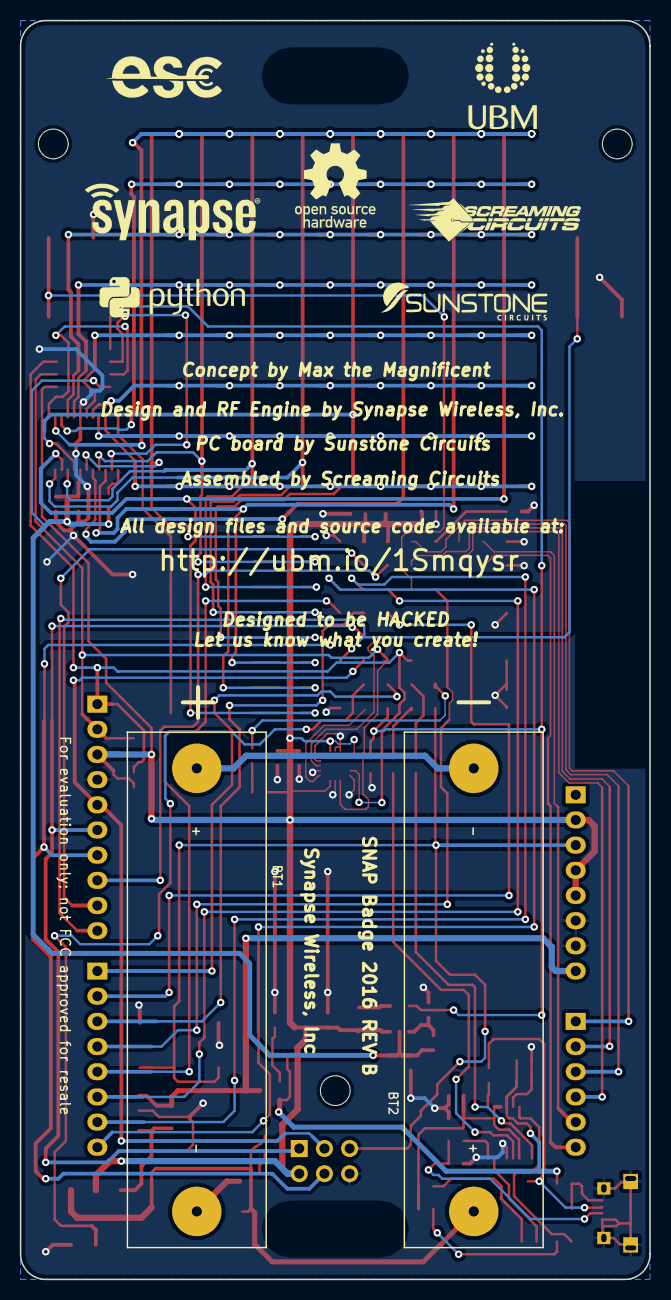
[picture p12: board SNAP_badge.kicad_pcb from below]

Board: 2 copper layers, 63.5 x 127.0 mm, 141 parts (2 on the bottom side), 86 nets.

Other parts of the board:
Fiducial_Mark: VAL**; Fiducial_Mark
Fiducial_Mark#2, Fiducial_Mark#3: VAL**; Fiducial_Mark
