DavidEwing/SNAP-Badge/(commit log)

2015-12-02 After 1st design review
    [LED_matrix.sch, test_board2.csv, test_board2.kicad_pcb, test_board2.sch]
2015-12-02 Arduino footprint laid out
    [LED_matrix.sch, test_board2.kicad_pcb, test_board2.sch]
2015-12-05 First placement
    [CostedBom1.xlsx, LED_matrix.sch, test_board2.csv, test_board2.kicad_pcb, test_board2.sch]
2015-12-07 Placement v1
    [LED_matrix.sch, test_board2.kicad_pcb, test_board2.sch]
2015-12-10 Placement complete.
    [LED_matrix.sch, test_board2.kicad_pcb, test_board2.sch]
2015-12-12 LEDs routed
    [test_board2.kicad_pcb]
2015-12-15 Routing complete
    [test_board2.kicad_pcb]
2015-12-15 Routing complete, first check. Prior to GND fill.
    [test_board2.kicad_pcb]
2015-12-15 Finished ground pours, all DRC passing
    [test_board2.kicad_pcb]
2015-12-16 Cleanup, first gerber gen
    [test_board2-B.Cu.gbl, test_board2-B.Mask.gbs, test_board2-B.SilkS.gbo, test_board2-Edge.Cuts.gm1, test_board2-F.Cu.gtl, test_board2-F.Mask.gts, test_board2-F.Paste.gtp, test_board2-F.SilkS.gto]
2015-12-17 First version sent to CM for review (Screaming Circuits)
    [LED_matrix.sch, SNAPbadge_BOM_Rev-A.xlsx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]
2015-12-18 Update sch with Mfg and PN fields, added Screaming Circuits to silk.
    [CostedBom1.xlsx, LED_matrix.sch, SNAPbadge_BOM_Rev-A.xlsx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]
2015-12-21 Beginning cleanup - rename badge project files
    [SNAP_badge.csv, SNAP_badge.kicad_pcb, SNAP_badge.sch, SNAPbadge_BOM_Rev-A_e351ad.xlsx]
2015-12-21 Change to refactored Kicad local libraries
    [LED_matrix.sch, SNAP_badge.kicad_pcb, SNAP_badge.sch]
2015-12-21 Rename gerbers
    [SNAP_badge-B.Cu.gbl, SNAP_badge-B.Mask.gbs, SNAP_badge-B.SilkS.gbo, SNAP_badge-Edge.Cuts.gm1, SNAP_badge-F.Cu.gtl, SNAP_badge-F.Mask.gts, SNAP_badge-F.Paste.gtp, SNAP_badge-F.SilkS.gto]
2015-12-21 BOM update
    [SNAP_badge.csv]
2015-12-21 Generated gerbers after library reorg
    [SNAP_badge-B.Cu.gbl, SNAP_badge-B.Mask.gbs, SNAP_badge-B.SilkS.gbo, SNAP_badge-Edge.Cuts.gm1, SNAP_badge-F.Cu.gtl, SNAP_badge-F.Mask.gts, SNAP_badge-F.Paste.gtp, SNAP_badge-F.SilkS.gto]
2015-12-22 Added 'INSERT' (aka SMD) property to footprints, so they appear in placement (.pos) file. Added .pos file.
    [SNAP_badge.kicad_pcb]
2015-12-22 Rename docs for consistency
    [SNAPbadge_BOM-RevA_e351ad.xlsx]
2015-12-22 Track gerber zip sent to CM
2015-12-22 Updated QSOP24 footprint 3D model scale (TSSOP/QSOP ratio)
    [SNAP_badge.kicad_pcb]
2016-02-09 Fixed LED silkscreen, added logos
    [LED_matrix.sch, SNAP_badge.csv, SNAP_badge.kicad_pcb, SNAP_badge.sch]
2016-02-18 Update silkscreen with logos, etc.
    [SNAP_badge-B.Cu.gbl, SNAP_badge-B.Mask.gbs, SNAP_badge-B.SilkS.gbo, SNAP_badge-Edge.Cuts.gm1, SNAP_badge-F.Cu.gtl, SNAP_badge-F.Mask.gts, SNAP_badge-F.Paste.gtp, SNAP_badge-F.SilkS.gto]
2016-02-18 Generated docs
    [SNAPbadge_BOM-RevB_f1cd7e.xlsx]
2016-02-18 Updated version to RevB
    [LED_matrix.sch, SNAP_badge.sch]
